riri6967/Guide-dog-rover/haptic_handle/drawings/handle_details.png

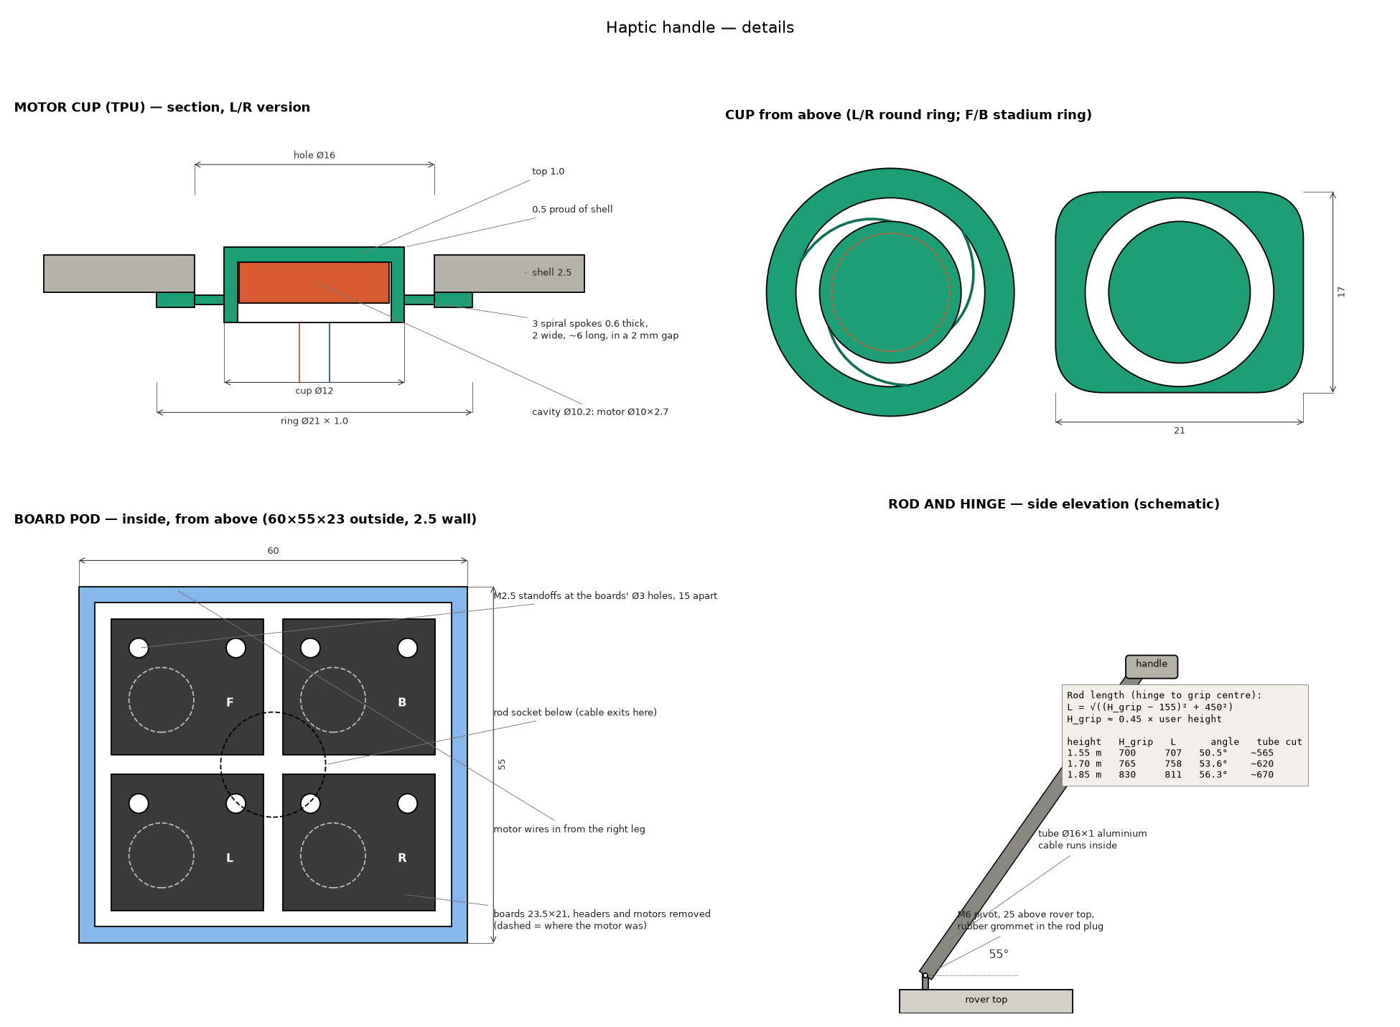
haptic_handle/drawings/handle_details.png
