riri6967/Guide-dog-rover/haptic_handle/drawings/handle_views.png

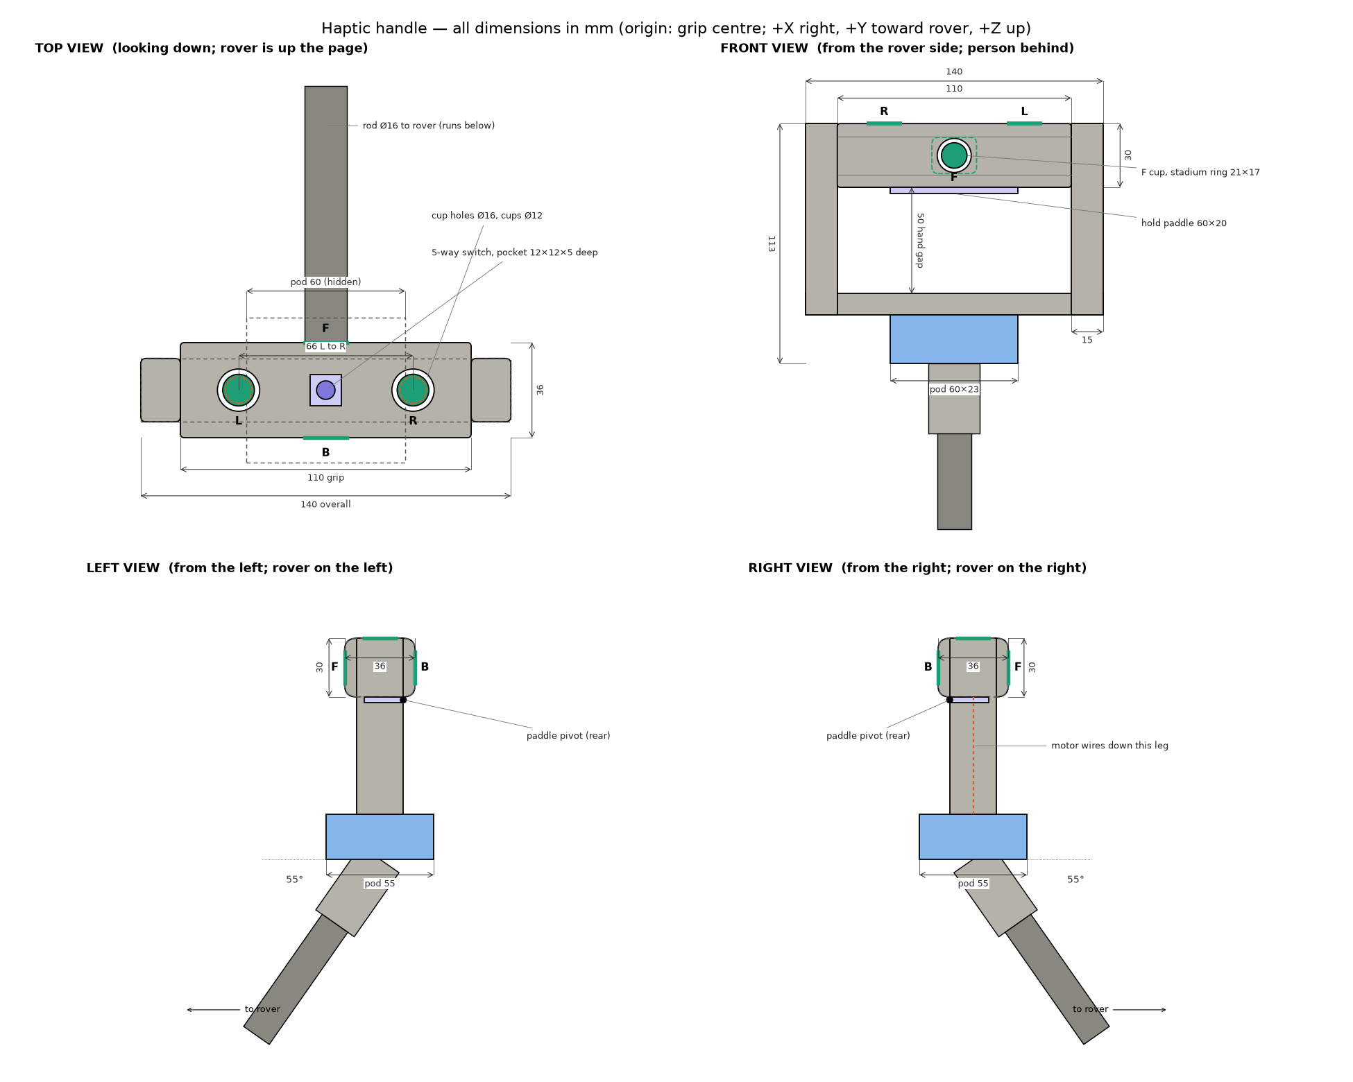
haptic_handle/drawings/handle_views.png
