riri6967/Guide-dog-rover/simulation/assistive_robot/training/worlds/gen/preview/train_samples.png

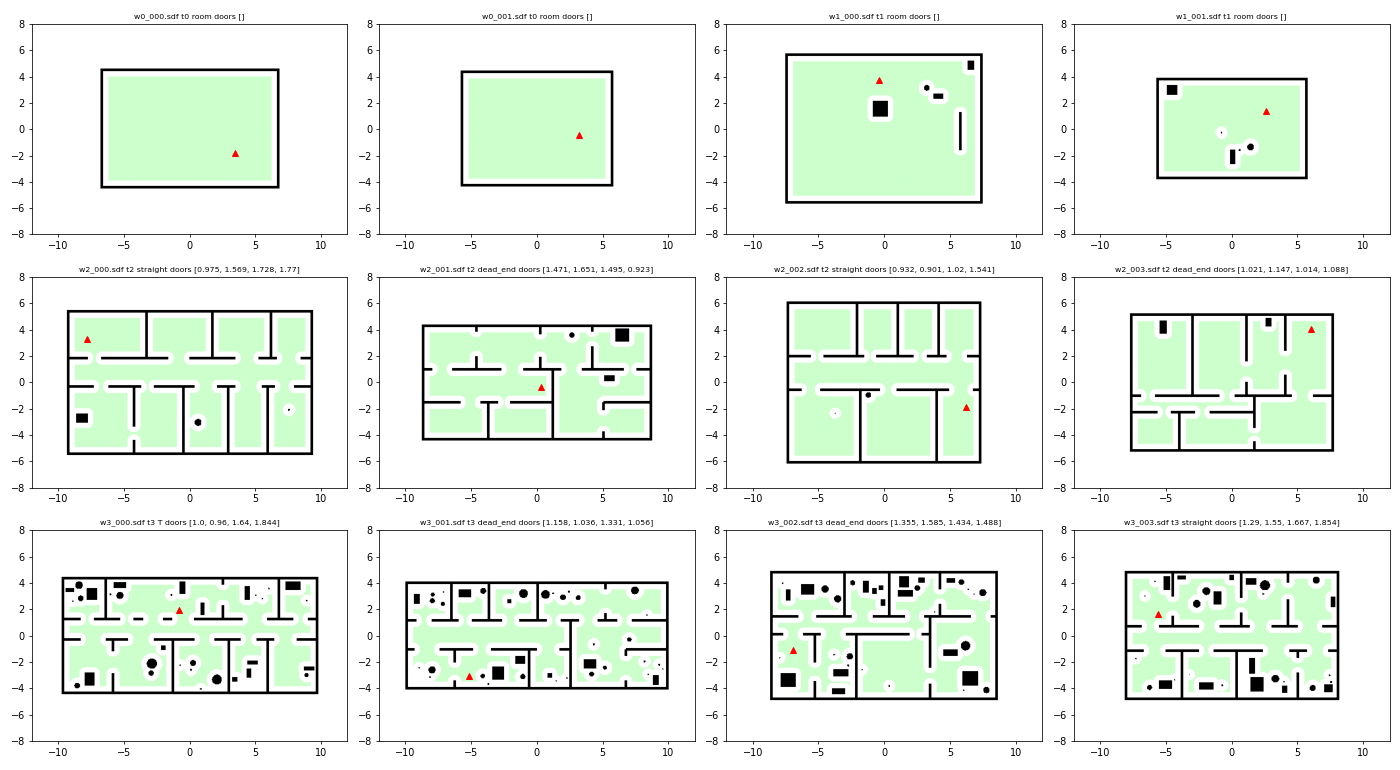
simulation/assistive_robot/training/worlds/gen/preview/train_samples.png
