riri6967/Guide-dog-rover/cad/stl/Encoder Holder Left.stl

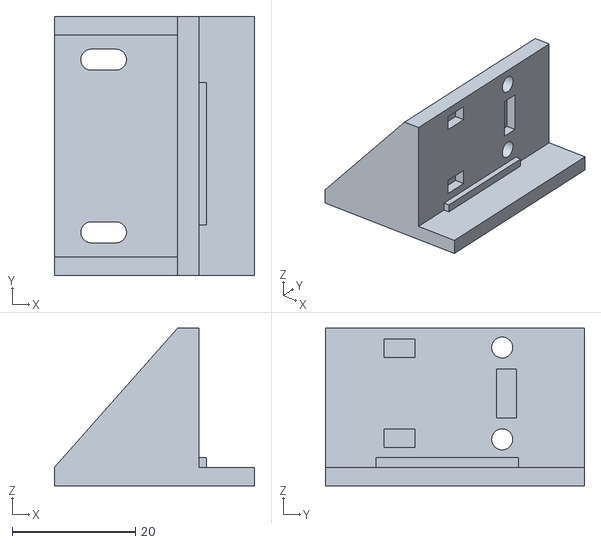
[picture p4: CAD file, 2026-11-06]
cad/stl/Encoder Holder Left.stl
32.5 x 42.0 x 25.6
