riri6967/Guide-dog-rover/raspberry_pi/ros/rover_description/meshes/shaft_extender.stl

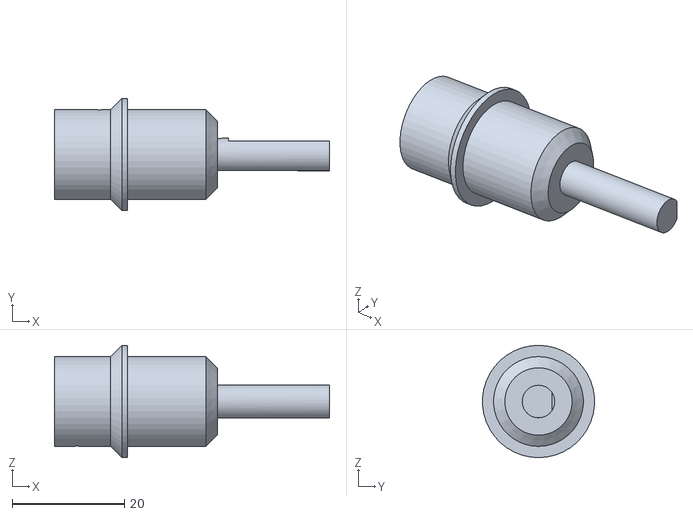
[picture p5: CAD file, 2026-11-06]
raspberry_pi/ros/rover_description/meshes/shaft_extender.stl
49.0 x 19.9 x 20.0
