riri6967/Guide-dog-rover/raspberry_pi/ros/rover_description/meshes/encoder_disc.stl

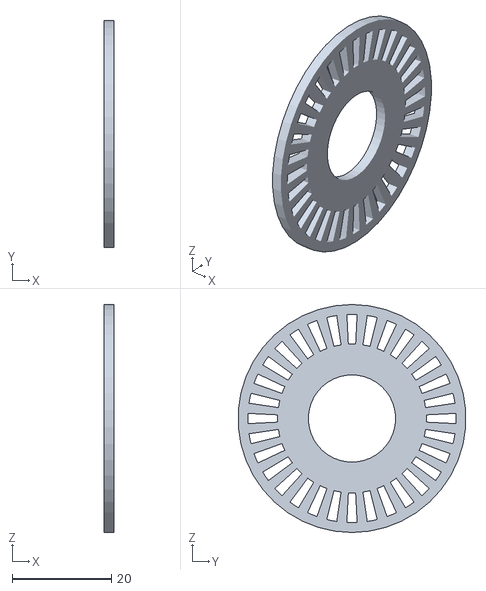
[picture p6: CAD file, 2026-11-06]
raspberry_pi/ros/rover_description/meshes/encoder_disc.stl
2.00 x 45.9 x 46.0
