riri6967/Guide-dog-rover/cad/stl/Encoder Disc B.stl

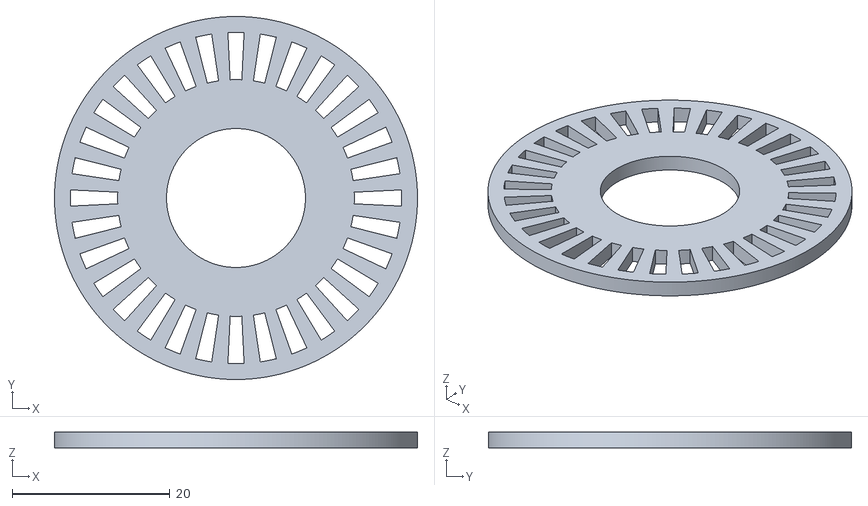
[picture p7: CAD file, 2026-11-06]
cad/stl/Encoder Disc B.stl
46.0 x 46.0 x 2.00
