riri6967/Guide-dog-rover/raspberry_pi/ros/rover_description/meshes/handle_grip.stl

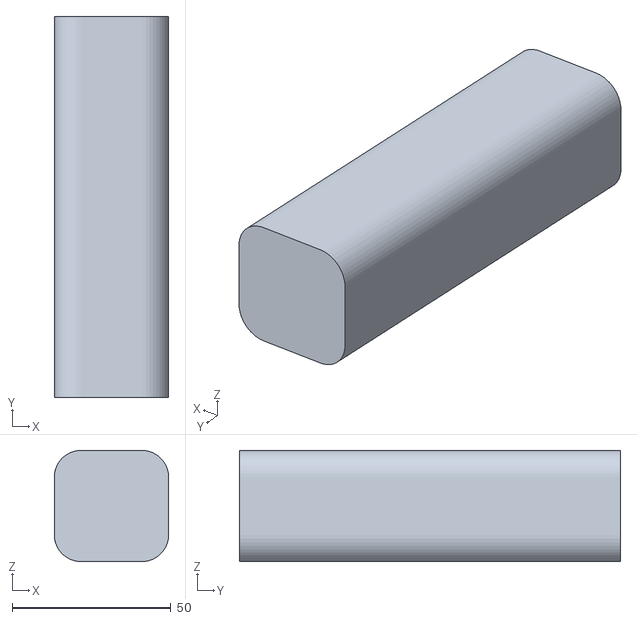
[picture p8: CAD file, 2026-11-03]
raspberry_pi/ros/rover_description/meshes/handle_grip.stl
36.0 x 120.0 x 35.0
