riri6967/Guide-dog-rover/raspberry_pi/ros/rover_description/meshes/handle_mount.stl

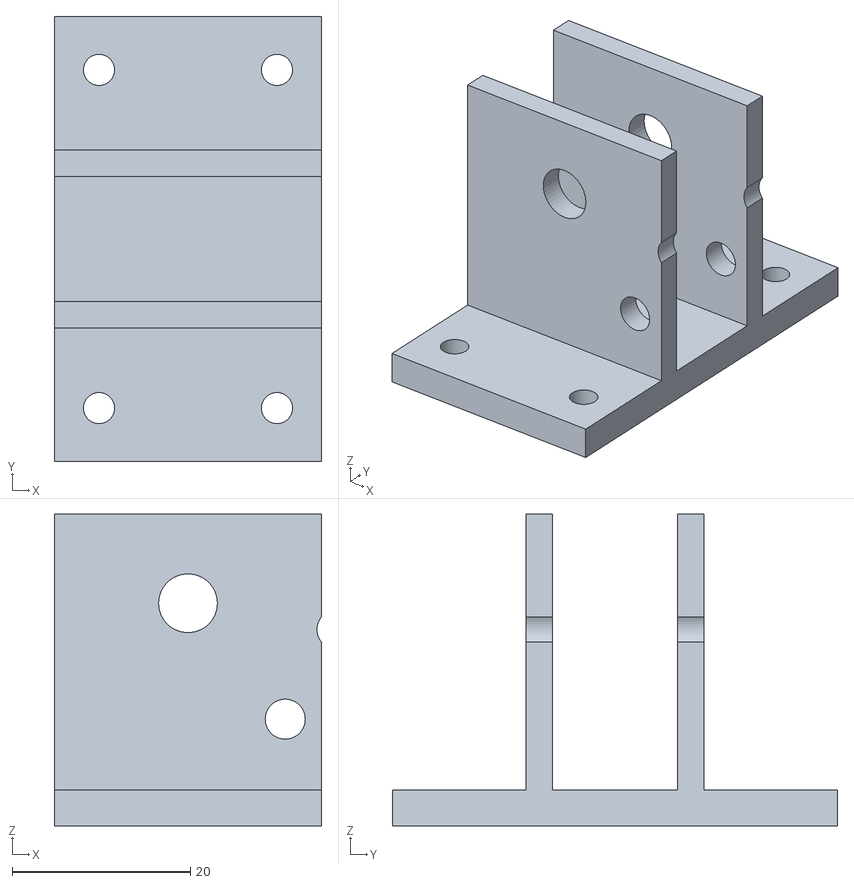
[picture p9: CAD file, 2026-11-03]
raspberry_pi/ros/rover_description/meshes/handle_mount.stl
30.0 x 50.0 x 35.0
