riri6967/Guide-dog-rover/raspberry_pi/ros/rover_description/meshes/handle_frame.stl

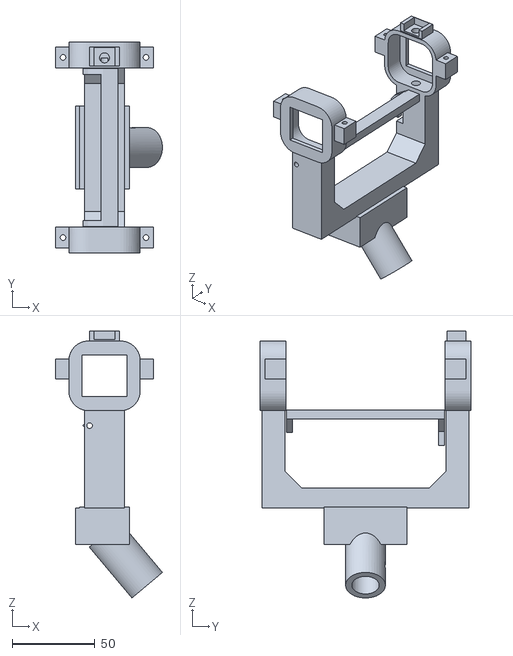
[picture p10: CAD file, 2026-11-03]
raspberry_pi/ros/rover_description/meshes/handle_frame.stl
64.4 x 127.0 x 160.9
