riri6967/Guide-dog-rover/cad/stl/Shaft Extender C.stl

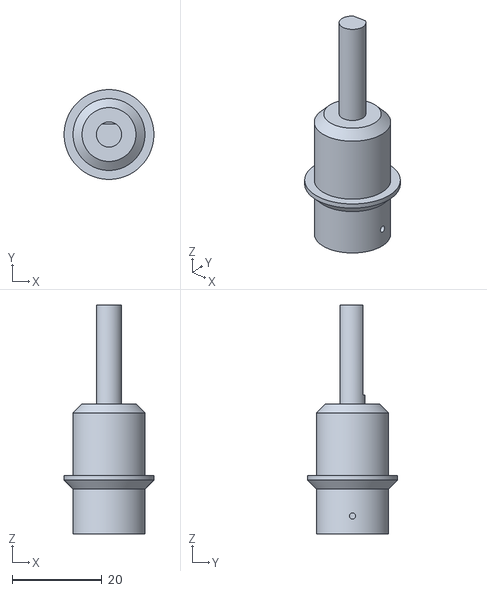
[picture p11: CAD file, 2026-11-06]
cad/stl/Shaft Extender C.stl
20.0 x 20.0 x 51.0
