riri6967/Guide-dog-rover/raspberry_pi/ros/rover_description/meshes/vibration_module.stl

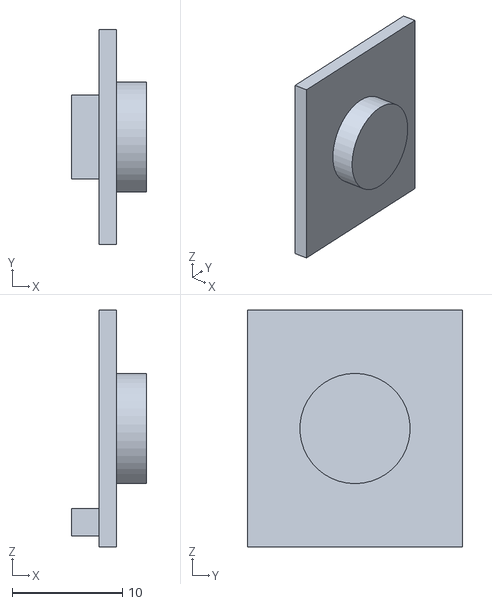
[picture p12: CAD file, 2026-11-03]
raspberry_pi/ros/rover_description/meshes/vibration_module.stl
6.80 x 19.5 x 21.5
