riri6967/Guide-dog-rover/cad/stl/Shaft Extender A.stl

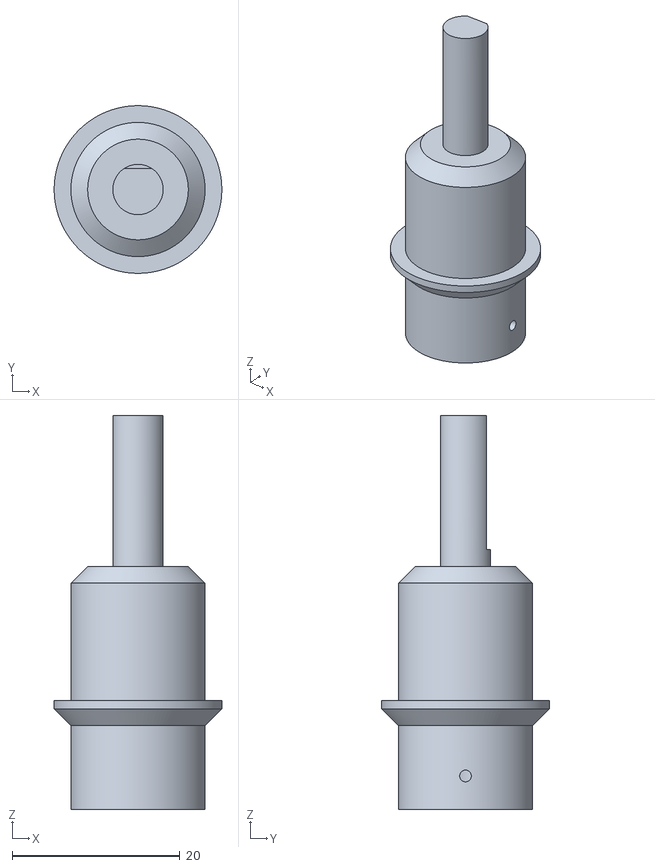
[picture p13: CAD file, 2026-11-06]
cad/stl/Shaft Extender A.stl
20.0 x 20.0 x 47.0
