riri6967/Guide-dog-rover/raspberry_pi/ros/rover_description/meshes/encoder_sensor_right.stl

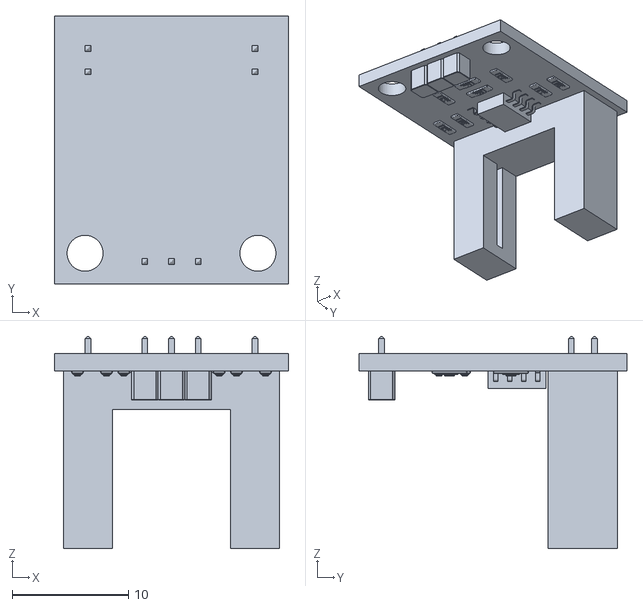
[picture p14: CAD file, 2026-11-03]
raspberry_pi/ros/rover_description/meshes/encoder_sensor_right.stl
20.2 x 23.1 x 18.3
