riri6967/Guide-dog-rover/raspberry_pi/ros/rover_description/meshes/handle_rod.stl

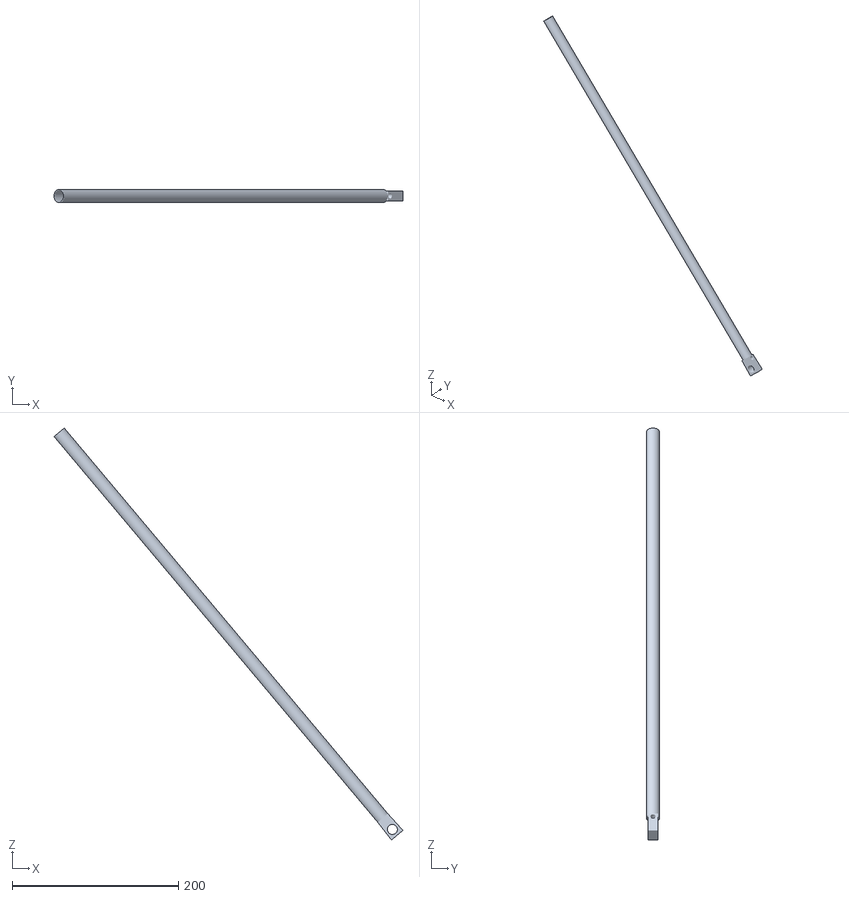
[picture p15: CAD file, 2026-11-03]
raspberry_pi/ros/rover_description/meshes/handle_rod.stl
419.3 x 16.0 x 495.1
