riri6967/Guide-dog-rover/raspberry_pi/ros/rover_description/meshes/imu.stl

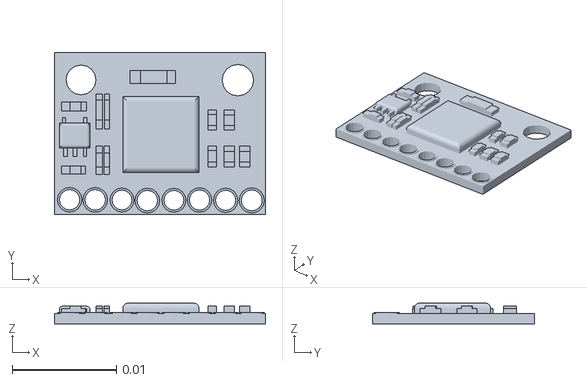
[picture p16: CAD file, 2026-10-14]
raspberry_pi/ros/rover_description/meshes/imu.stl
0.0203 x 0.0156 x 0.002
