riri6967/Guide-dog-rover/raspberry_pi/ros/rover_description/meshes/front_left_wheel.stl

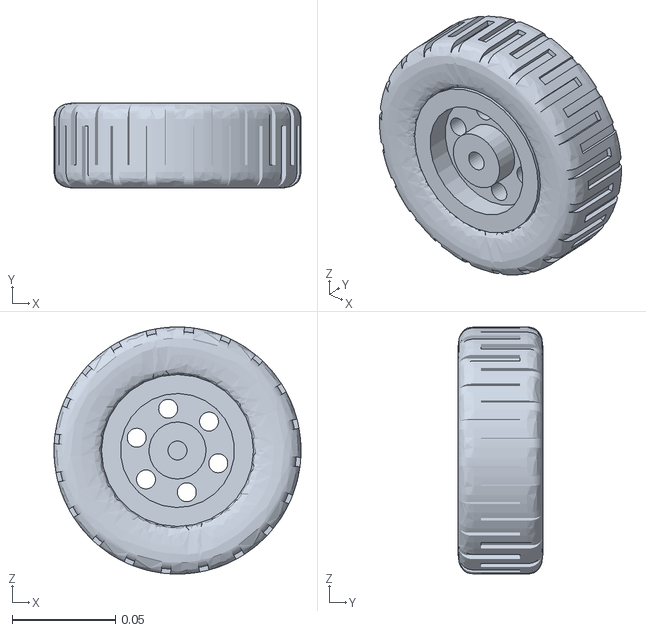
[picture p17: CAD file, 2026-10-14]
raspberry_pi/ros/rover_description/meshes/front_left_wheel.stl
0.12 x 0.0411 x 0.12
