riri6967/Guide-dog-rover/raspberry_pi/ros/rover_description/meshes/camera.stl

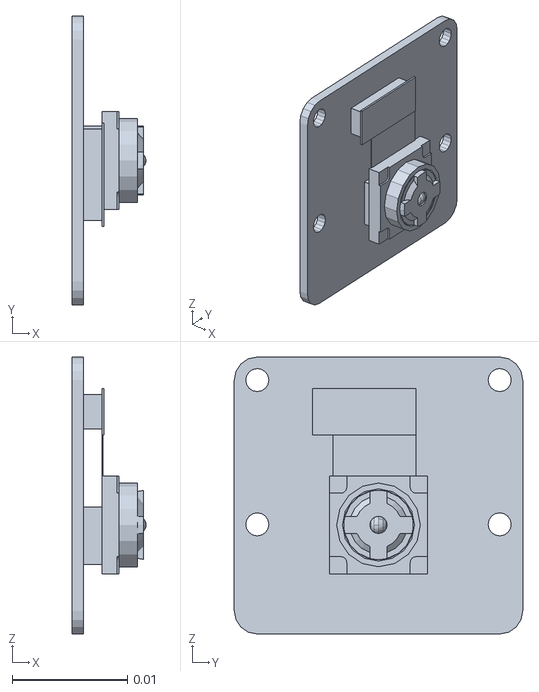
[picture p18: CAD file, 2026-10-14]
raspberry_pi/ros/rover_description/meshes/camera.stl
0.00645 x 0.025 x 0.024
