riri6967/Guide-dog-rover/raspberry_pi/ros/rover_description/meshes/lidar.stl

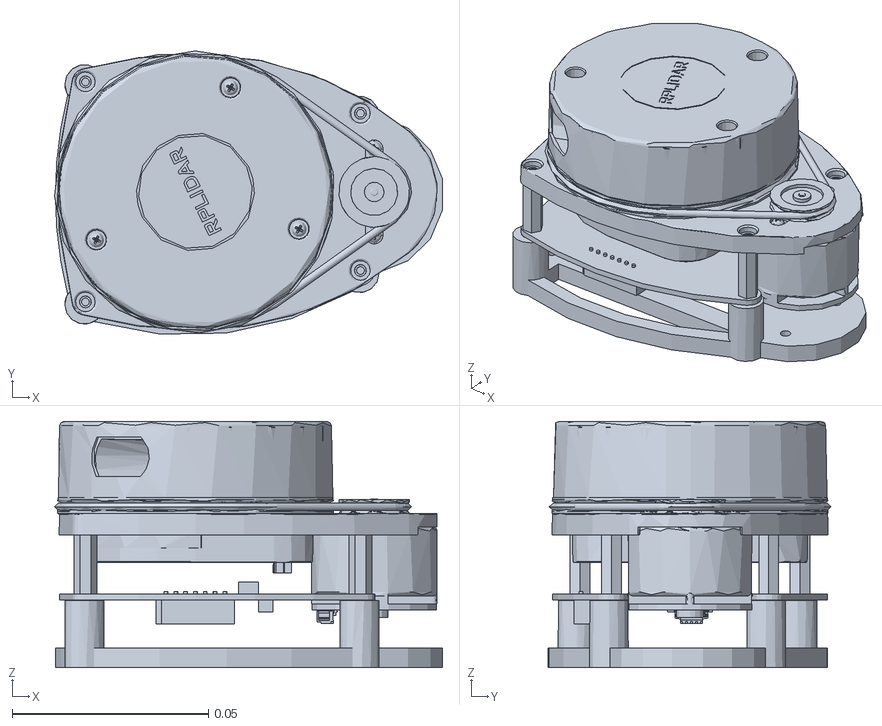
[picture p19: CAD file, 2026-10-14]
raspberry_pi/ros/rover_description/meshes/lidar.stl
0.0988 x 0.0721 x 0.0626
