riri6967/Guide-dog-rover/raspberry_pi/ros/rover_description/meshes/chassis.stl

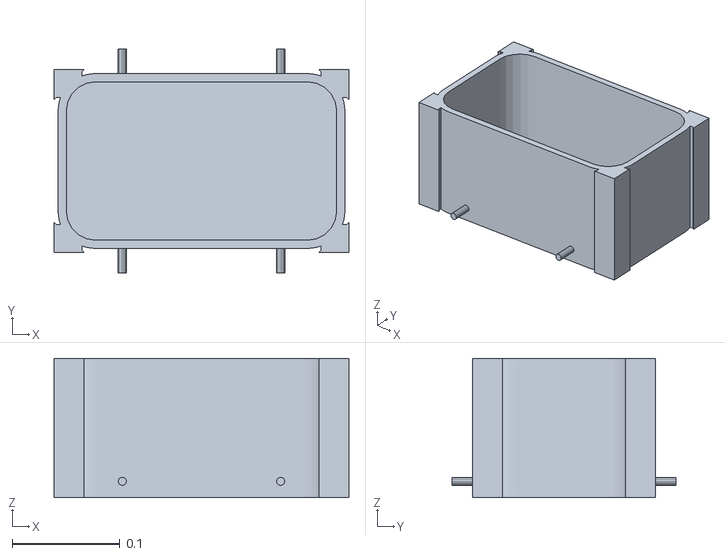
[picture p20: CAD file, 2026-10-14]
raspberry_pi/ros/rover_description/meshes/chassis.stl
0.274 x 0.208 x 0.13
