riri6967/Guide-dog-rover/(list of files, cad)

Other CAD files:
cad/stl/Encoder Holder Right.stl
cad/stl/Encoder Disc C.stl
cad/stl/Encoder Disc A.stl
cad/stl/Shaft Extender B.stl
raspberry_pi/ros/rover_description/meshes/encoder_sensor_left.stl
raspberry_pi/ros/rover_description/meshes/encoder_holder_right.stl
raspberry_pi/ros/rover_description/meshes/encoder_holder_left.stl
raspberry_pi/ros/rover_description/meshes/rear_left_wheel.stl
raspberry_pi/ros/rover_description/meshes/rear_right_wheel.stl
raspberry_pi/ros/rover_description/meshes/front_right_wheel.stl
