riri6967/Guide-dog-rover/simulation/guide_dog_simulator.html

# Guide Dog Rover Simulator

Your rover leading a blind person through the Gazebo test house. The person holds the rigid handle; the four motors in the grip tell them where they are about to be steered.

sim time 0:00 · 2× real speed

Run 6-goal tour Back to start

Click map to

Set goal Drop box Add walker

Hold (stop) Cut handle link

Speed

1× 2× 4× 8×

Pause Reset

Navigating Starting the tour

Click to send the rover somewhere · arrow keys or WASD to drive it yourself

LiDAR beams Costmap Planned path Follow rover Hear the grip (headphones)

Rover 0.90 × 0.76 m Person on the handle Planned path Too close for the rover / seen by LiDAR Furniture

## Handle grip · what the person feels

Silence

Carry on straight.

- SilenceGo forward, all clear
- Left / rightSteady buzz on that side, stronger = sharper turn
- Front pulsingObstacle ahead, faster as it gets closer
- All four pulsingStop walking
- Back steadyStep back
- Two soft pulsesArrived
- Three short pulsesLink lost, the handle has gone blind

## On the ROS graph

/cmd_vel linear.x

0.00 m/s

/cmd_vel angular.z

0.00 rad/s

/scan nearest

–

clear space ahead

–

/ticks_left

0

/ticks_right

0

pose x, y, yaw

0.00, 0.00, 0°

distance to goal

–

## Event log

## Tour results · the 6 goals from nav2/goals.csv

Goal | Where | This run | Time | Driven | Closest | Gazebo Nav2 baseline

Goals run back-to-back, each starting where the last one ended, like auto_nav2_eval_v2.py. A goal counts as reached within 0.25 m; it times out after 150 s of sim time. The last column is the frozen Gazebo baseline (3 passes each). In the full Gazebo comparison Nav2 reached 26/36 goals (72%) and the DRL + MPPI hybrid 25/36 (69%).

## Built from your project

- House layout, walls, door posts and furniture from simulation/assistive_robot/baseline_20261010/world/assistive_world.sdf, to scale.
- Rover footprint 0.90 × 0.76 m, speed up to 0.3 m/s, turn up to 1.0 rad/s, goal tolerance 0.15 m, from nav2_params.yaml.
- LiDAR: 360 beams, 0.12 to 15 m; new obstacles are marked within 3.5 m, as in the tuned costmap.
- Grip feedback ported line for line from haptic_handle/haptics.cpp: duty levels 70 / 150 / 255, deadbands 0.03 m/s and 0.10 rad/s, stop at 5 Hz, link-lost triple pulse every 1.6 s.
- Encoder ticks: 32 per wheel turn, the slotted disc in rover_microros.ino.

Simplified here: the planner is A* on a 10 cm grid with a pure-pursuit follower instead of SmacPlanner2D + MPPI, the rover knows its true position (no AMCL drift), and the DRL policy is not included. Treat the times as illustrative, not as new measurements.
