riri6967/Guide-dog-rover/simulation/assistive_robot/training/runs/sac_gen_20261010_113224/eval_test/world_log.csv

time | event | worker | world
1791621427.6 | launch | 0 | w0_000
1791621427.6 | launch | 1 | w0_001
1791621427.6 | launch | 2 | w0_002
1791621427.6 | launch | 3 | w0_003
1791621427.6 | launch | 4 | w0_004
1791621427.6 | launch | 5 | w0_005
1791621427.6 | launch | 6 | w1_000
1791621427.6 | launch | 7 | w1_001
1791621427.6 | launch | 8 | w1_002
1791621430.7 | active | 7 | w1_001
1791621430.7 | active | 4 | w0_004
1791621430.7 | active | 5 | w0_005
1791621433.5 | active | 6 | w1_000
1791621433.6 | active | 1 | w0_001
1791621433.6 | active | 0 | w0_000
1791621466.5 | active | 2 | w0_002
1791621466.5 | retire | 1 | w0_001
1791621466.5 | launch | 9 | w1_003
1791621469.6 | active | 3 | w0_003
1791621469.6 | retire | 5 | w0_005
1791621469.6 | launch | 10 | w1_004
1791621473.7 | active | 8 | w1_002
1791621473.7 | retire | 4 | w0_004
1791621473.7 | launch | 11 | w1_005
1791621480.0 | active | 9 | w1_003
1791621480.0 | retire | 0 | w0_000
1791621480.0 | launch | 12 | w1_006
1791621480.6 | active | 10 | w1_004
1791621480.6 | retire | 7 | w1_001
1791621480.6 | launch | 13 | w1_007
1791621485.1 | active | 11 | w1_005
1791621485.1 | retire | 6 | w1_000
1791621485.1 | launch | 14 | w2_000
1791621507.1 | active | 12 | w1_006
1791621507.1 | retire | 2 | w0_002
1791621507.1 | launch | 15 | w2_001
1791621512.7 | active | 13 | w1_007
1791621512.7 | retire | 8 | w1_002
1791621512.7 | launch | 16 | w2_002
1791621514.1 | active | 14 | w2_000
1791621514.1 | retire | 3 | w0_003
1791621514.1 | launch | 17 | w2_003
1791621527.4 | active | 15 | w2_001
1791621527.4 | retire | 9 | w1_003
1791621527.4 | launch | 18 | w2_004
1791621529.4 | active | 16 | w2_002
1791621529.4 | retire | 10 | w1_004
1791621529.4 | launch | 19 | w2_005
1791621537.3 | active | 17 | w2_003
1791621537.3 | retire | 12 | w1_006
1791621537.3 | launch | 20 | w2_006
1791621539.2 | active | 18 | w2_004
1791621539.2 | retire | 11 | w1_005
1791621539.2 | launch | 21 | w2_007
1791621561.8 | active | 19 | w2_005
1791621561.8 | retire | 13 | w1_007
1791621561.8 | launch | 22 | w3_000
1791621568.7 | active | 20 | w2_006
1791621568.7 | retire | 16 | w2_002
1791621568.7 | launch | 23 | w3_001
1791621572.0 | active | 21 | w2_007
1791621572.0 | retire | 15 | w2_001
1791621572.0 | launch | 24 | w3_002
1791621576.3 | active | 22 | w3_000
1791621576.3 | retire | 14 | w2_000
1791621576.3 | launch | 25 | w3_003
1791621579.3 | active | 23 | w3_001
1791621579.3 | retire | 18 | w2_004
1791621579.3 | launch | 26 | w3_004
1791621597.0 | active | 24 | w3_002
1791621597.0 | retire | 17 | w2_003
1791621597.0 | launch | 27 | w3_005
1791621604.5 | active | 25 | w3_003
1791621604.5 | retire | 20 | w2_006
1791621604.5 | launch | 28 | w3_006
1791621609.1 | active | 26 | w3_004
1791621609.1 | retire | 22 | w3_000
1791621609.1 | launch | 29 | w3_007
1791621612.3 | active | 27 | w3_005
1791621612.3 | retire | 21 | w2_007
1791621612.3 | launch | 30 | w0_000
1791621615.2 | active | 28 | w3_006
1791621615.2 | retire | 19 | w2_005
1791621615.2 | launch | 31 | w0_001
1791621615.3 | active | 29 | w3_007
1791621615.3 | retire | 23 | w3_001
1791621615.3 | launch | 32 | w0_002
1791621640.8 | active | 30 | w0_000
1791621640.8 | retire | 25 | w3_003
1791621640.8 | launch | 33 | w0_003
1791621642.0 | active | 31 | w0_001
1791621642.0 | retire | 24 | w3_002
1791621642.0 | launch | 34 | w0_004
1791621650.4 | active | 32 | w0_002
1791621650.4 | retire | 27 | w3_005
1791621650.4 | launch | 35 | w0_005
1791621651.9 | active | 33 | w0_003
1791621651.9 | retire | 26 | w3_004
1791621651.9 | launch | 36 | w1_000
1791621669.2 | active | 34 | w0_004
1791621669.2 | retire | 29 | w3_007
1791621669.2 | launch | 37 | w1_001
1791621672.5 | active | 35 | w0_005
1791621672.5 | retire | 28 | w3_006
1791621672.5 | launch | 38 | w1_002
