riri6967/Guide-dog-rover/simulation/assistive_robot/training/runs/sac_gen_20261010_142340/eval_test/world_log.csv

time | event | worker | world
1791631739.0 | launch | 0 | w0_000
1791631739.0 | launch | 1 | w0_001
1791631739.0 | launch | 2 | w0_002
1791631739.0 | launch | 3 | w0_003
1791631739.0 | launch | 4 | w0_004
1791631739.0 | launch | 5 | w0_005
1791631739.0 | launch | 6 | w1_000
1791631739.0 | launch | 7 | w1_001
1791631739.0 | launch | 8 | w1_002
1791631742.0 | active | 4 | w0_004
1791631742.1 | active | 3 | w0_003
1791631742.1 | active | 0 | w0_000
1791631744.9 | active | 7 | w1_001
1791631745.0 | active | 5 | w0_005
1791631745.0 | active | 2 | w0_002
1791631781.0 | active | 8 | w1_002
1791631781.0 | retire | 5 | w0_005
1791631781.0 | launch | 9 | w1_003
1791631789.1 | active | 1 | w0_001
1791631789.1 | retire | 2 | w0_002
1791631789.1 | launch | 10 | w1_004
1791631790.6 | active | 6 | w1_000
1791631790.6 | retire | 4 | w0_004
1791631790.6 | launch | 11 | w1_005
1791631791.0 | active | 9 | w1_003
1791631791.0 | retire | 3 | w0_003
1791631791.0 | launch | 12 | w1_006
1791631792.9 | active | 10 | w1_004
1791631792.9 | retire | 7 | w1_001
1791631792.9 | launch | 13 | w1_007
1791631801.1 | active | 11 | w1_005
1791631801.1 | retire | 0 | w0_000
1791631801.1 | launch | 14 | w2_000
1791631822.8 | active | 12 | w1_006
1791631822.8 | retire | 1 | w0_001
1791631822.8 | launch | 15 | w2_001
1791631825.9 | active | 13 | w1_007
1791631825.9 | retire | 8 | w1_002
1791631825.9 | launch | 16 | w2_002
1791631834.8 | active | 14 | w2_000
1791631834.8 | retire | 6 | w1_000
1791631834.8 | launch | 17 | w2_003
1791631838.0 | active | 15 | w2_001
1791631838.0 | retire | 9 | w1_003
1791631838.0 | launch | 18 | w2_004
1791631842.0 | active | 16 | w2_002
1791631842.0 | retire | 10 | w1_004
1791631842.0 | launch | 19 | w2_005
1791631850.1 | active | 17 | w2_003
1791631850.1 | retire | 11 | w1_005
1791631850.1 | launch | 20 | w2_006
1791631851.7 | active | 18 | w2_004
1791631851.7 | retire | 12 | w1_006
1791631851.7 | launch | 21 | w2_007
1791631868.2 | active | 19 | w2_005
1791631868.2 | retire | 13 | w1_007
1791631868.2 | launch | 22 | w3_000
1791631886.2 | active | 20 | w2_006
1791631886.2 | retire | 16 | w2_002
1791631886.2 | launch | 23 | w3_001
1791631887.0 | active | 21 | w2_007
1791631887.0 | retire | 15 | w2_001
1791631887.0 | launch | 24 | w3_002
1791631898.1 | active | 22 | w3_000
1791631898.1 | retire | 14 | w2_000
1791631898.1 | launch | 25 | w3_003
1791631904.1 | active | 23 | w3_001
1791631904.1 | retire | 18 | w2_004
1791631904.1 | launch | 26 | w3_004
1791631911.3 | active | 24 | w3_002
1791631911.3 | retire | 17 | w2_003
1791631911.3 | launch | 27 | w3_005
1791631921.2 | active | 25 | w3_003
1791631921.2 | retire | 20 | w2_006
1791631921.2 | launch | 28 | w3_006
1791631928.4 | active | 26 | w3_004
1791631928.4 | retire | 19 | w2_005
1791631928.4 | launch | 29 | w3_007
1791631933.9 | active | 27 | w3_005
1791631933.9 | retire | 22 | w3_000
1791631933.9 | launch | 30 | w0_000
1791631935.6 | active | 28 | w3_006
1791631935.6 | retire | 23 | w3_001
1791631935.6 | launch | 31 | w0_001
1791631936.4 | active | 29 | w3_007
1791631936.4 | retire | 21 | w2_007
1791631936.4 | launch | 32 | w0_002
1791631953.7 | active | 30 | w0_000
1791631953.7 | retire | 25 | w3_003
1791631953.7 | launch | 33 | w0_003
1791631957.8 | active | 31 | w0_001
1791631957.8 | retire | 24 | w3_002
1791631957.8 | launch | 34 | w0_004
1791631964.1 | active | 32 | w0_002
1791631964.1 | retire | 27 | w3_005
1791631964.1 | launch | 35 | w0_005
1791631976.9 | active | 33 | w0_003
1791631976.9 | retire | 26 | w3_004
1791631976.9 | launch | 36 | w1_000
1791631991.6 | active | 34 | w0_004
1791631991.6 | retire | 31 | w0_001
1791631991.6 | launch | 37 | w1_001
1791631994.5 | active | 35 | w0_005
1791631994.5 | retire | 28 | w3_006
1791631994.5 | launch | 38 | w1_002
1791631996.6 | active | 36 | w1_000
1791631996.6 | retire | 29 | w3_007
1791631996.6 | launch | 39 | w1_003
