riri6967/Guide-dog-rover/simulation/assistive_robot/training/runs/sac_gen_20261010_234158/eval_test/world_log.csv

time | event | worker | world
1791665231.0 | launch | 0 | w0_000
1791665231.0 | launch | 1 | w0_001
1791665231.0 | launch | 2 | w0_002
1791665231.0 | launch | 3 | w0_003
1791665231.0 | launch | 4 | w0_004
1791665231.0 | launch | 5 | w0_005
1791665231.0 | launch | 6 | w1_000
1791665231.0 | launch | 7 | w1_001
1791665231.0 | launch | 8 | w1_002
1791665234.1 | active | 5 | w0_005
1791665234.1 | active | 2 | w0_002
1791665234.2 | active | 6 | w1_000
1791665236.8 | active | 0 | w0_000
1791665236.8 | active | 3 | w0_003
1791665236.9 | active | 7 | w1_001
1791665273.5 | active | 1 | w0_001
1791665273.5 | retire | 5 | w0_005
1791665273.5 | launch | 9 | w1_003
1791665281.2 | active | 8 | w1_002
1791665281.2 | retire | 2 | w0_002
1791665281.2 | launch | 10 | w1_004
1791665282.9 | active | 4 | w0_004
1791665282.9 | retire | 3 | w0_003
1791665282.9 | launch | 11 | w1_005
1791665285.5 | active | 9 | w1_003
1791665285.5 | retire | 7 | w1_001
1791665285.5 | launch | 12 | w1_006
1791665285.9 | active | 10 | w1_004
1791665285.9 | retire | 0 | w0_000
1791665285.9 | launch | 13 | w1_007
1791665288.0 | active | 11 | w1_005
1791665288.0 | retire | 6 | w1_000
1791665288.0 | launch | 14 | w2_000
1791665308.0 | active | 12 | w1_006
1791665308.0 | retire | 1 | w0_001
1791665308.0 | launch | 15 | w2_001
1791665325.7 | active | 13 | w1_007
1791665325.7 | retire | 4 | w0_004
1791665325.7 | launch | 16 | w2_002
1791665327.2 | active | 14 | w2_000
1791665327.2 | retire | 8 | w1_002
1791665327.2 | launch | 17 | w2_003
1791665334.3 | active | 15 | w2_001
1791665334.3 | retire | 9 | w1_003
1791665334.3 | launch | 18 | w2_004
1791665337.9 | active | 16 | w2_002
1791665337.9 | retire | 10 | w1_004
1791665337.9 | launch | 19 | w2_005
1791665338.3 | active | 17 | w2_003
1791665338.3 | retire | 12 | w1_006
1791665338.3 | launch | 20 | w2_006
1791665343.4 | active | 18 | w2_004
1791665343.4 | retire | 11 | w1_005
1791665343.4 | launch | 21 | w2_007
1791665370.4 | active | 19 | w2_005
1791665370.4 | retire | 13 | w1_007
1791665370.4 | launch | 22 | w3_000
1791665372.7 | active | 20 | w2_006
1791665372.7 | retire | 15 | w2_001
1791665372.7 | launch | 23 | w3_001
1791665378.6 | active | 21 | w2_007
1791665378.6 | retire | 16 | w2_002
1791665378.6 | launch | 24 | w3_002
1791665391.1 | active | 22 | w3_000
1791665391.1 | retire | 14 | w2_000
1791665391.1 | launch | 25 | w3_003
1791665392.6 | active | 23 | w3_001
1791665392.6 | retire | 18 | w2_004
1791665392.6 | launch | 26 | w3_004
1791665407.2 | active | 24 | w3_002
1791665407.2 | retire | 17 | w2_003
1791665407.2 | launch | 27 | w3_005
1791665419.5 | active | 25 | w3_003
1791665419.5 | retire | 20 | w2_006
1791665419.5 | launch | 28 | w3_006
1791665420.7 | active | 26 | w3_004
1791665420.7 | retire | 21 | w2_007
1791665420.7 | launch | 29 | w3_007
1791665423.2 | active | 27 | w3_005
1791665423.2 | retire | 23 | w3_001
1791665423.2 | launch | 30 | w0_000
1791665428.4 | active | 28 | w3_006
1791665428.4 | retire | 22 | w3_000
1791665428.4 | launch | 31 | w0_001
1791665430.6 | active | 29 | w3_007
1791665430.6 | retire | 19 | w2_005
1791665430.6 | launch | 32 | w0_002
1791665454.7 | active | 30 | w0_000
1791665454.7 | retire | 24 | w3_002
1791665454.7 | launch | 33 | w0_003
1791665457.2 | active | 31 | w0_001
1791665457.2 | retire | 27 | w3_005
1791665457.2 | launch | 34 | w0_004
1791665463.4 | active | 32 | w0_002
1791665463.4 | retire | 25 | w3_003
1791665463.4 | launch | 35 | w0_005
1791665469.4 | active | 33 | w0_003
1791665469.4 | retire | 26 | w3_004
1791665469.4 | launch | 36 | w1_000
1791665489.9 | active | 34 | w0_004
1791665489.9 | retire | 28 | w3_006
1791665489.9 | launch | 37 | w1_001
1791665493.0 | active | 35 | w0_005
1791665493.0 | retire | 31 | w0_001
1791665493.0 | launch | 38 | w1_002
1791665493.7 | active | 36 | w1_000
1791665493.7 | retire | 29 | w3_007
1791665493.7 | launch | 39 | w1_003
