riri6967/Guide-dog-rover/simulation/assistive_robot/training/runs/sac_gen_20261011_055331/eval_test/world_log.csv

time | event | worker | world
1791687464.9 | launch | 0 | w0_000
1791687464.9 | launch | 1 | w0_001
1791687464.9 | launch | 2 | w0_002
1791687464.9 | launch | 3 | w0_003
1791687464.9 | launch | 4 | w0_004
1791687464.9 | launch | 5 | w0_005
1791687464.9 | launch | 6 | w1_000
1791687464.9 | launch | 7 | w1_001
1791687464.9 | launch | 8 | w1_002
1791687467.9 | active | 6 | w1_000
1791687468.0 | active | 2 | w0_002
1791687468.0 | active | 0 | w0_000
1791687470.6 | active | 8 | w1_002
1791687470.7 | active | 4 | w0_004
1791687470.7 | active | 7 | w1_001
1791687500.9 | active | 1 | w0_001
1791687500.9 | retire | 8 | w1_002
1791687500.9 | launch | 9 | w1_003
1791687505.4 | active | 5 | w0_005
1791687505.4 | retire | 4 | w0_004
1791687505.4 | launch | 10 | w1_004
1791687509.3 | active | 3 | w0_003
1791687509.3 | retire | 2 | w0_002
1791687509.3 | launch | 11 | w1_005
1791687509.5 | active | 9 | w1_003
1791687509.5 | retire | 0 | w0_000
1791687509.5 | launch | 12 | w1_006
1791687513.7 | active | 10 | w1_004
1791687513.7 | retire | 7 | w1_001
1791687513.7 | launch | 13 | w1_007
1791687514.9 | active | 11 | w1_005
1791687514.9 | retire | 6 | w1_000
1791687514.9 | launch | 14 | w2_000
1791687530.1 | active | 12 | w1_006
1791687530.1 | retire | 1 | w0_001
1791687530.1 | launch | 15 | w2_001
1791687539.5 | active | 13 | w1_007
1791687539.5 | retire | 5 | w0_005
1791687539.5 | launch | 16 | w2_002
1791687548.8 | active | 14 | w2_000
1791687548.8 | retire | 3 | w0_003
1791687548.8 | launch | 17 | w2_003
1791687550.4 | active | 15 | w2_001
1791687550.4 | retire | 9 | w1_003
1791687550.4 | launch | 18 | w2_004
1791687556.7 | active | 16 | w2_002
1791687556.7 | retire | 11 | w1_005
1791687556.7 | launch | 19 | w2_005
1791687557.0 | active | 17 | w2_003
1791687557.0 | retire | 12 | w1_006
1791687557.0 | launch | 20 | w2_006
1791687558.4 | active | 18 | w2_004
1791687558.4 | retire | 10 | w1_004
1791687558.4 | launch | 21 | w2_007
1791687576.2 | active | 19 | w2_005
1791687576.2 | retire | 15 | w2_001
1791687576.2 | launch | 22 | w3_000
1791687580.4 | active | 20 | w2_006
1791687580.4 | retire | 13 | w1_007
1791687580.4 | launch | 23 | w3_001
1791687589.2 | active | 21 | w2_007
1791687589.2 | retire | 16 | w2_002
1791687589.2 | launch | 24 | w3_002
1791687598.9 | active | 22 | w3_000
1791687598.9 | retire | 14 | w2_000
1791687598.9 | launch | 25 | w3_003
1791687604.8 | active | 23 | w3_001
1791687604.8 | retire | 18 | w2_004
1791687604.8 | launch | 26 | w3_004
1791687613.3 | active | 24 | w3_002
1791687613.3 | retire | 20 | w2_006
1791687613.3 | launch | 27 | w3_005
1791687619.0 | active | 25 | w3_003
1791687619.0 | retire | 17 | w2_003
1791687619.0 | launch | 28 | w3_006
1791687624.0 | active | 26 | w3_004
1791687624.0 | retire | 19 | w2_005
1791687624.0 | launch | 29 | w3_007
1791687629.4 | active | 27 | w3_005
1791687629.4 | retire | 21 | w2_007
1791687629.4 | launch | 30 | w0_000
1791687632.3 | active | 28 | w3_006
1791687632.3 | retire | 22 | w3_000
1791687632.3 | launch | 31 | w0_001
1791687634.8 | active | 29 | w3_007
1791687634.8 | retire | 23 | w3_001
1791687634.8 | launch | 32 | w0_002
1791687648.4 | active | 30 | w0_000
1791687648.4 | retire | 24 | w3_002
1791687648.4 | launch | 33 | w0_003
1791687653.1 | active | 31 | w0_001
1791687653.1 | retire | 25 | w3_003
1791687653.1 | launch | 34 | w0_004
1791687658.9 | active | 32 | w0_002
1791687658.9 | retire | 26 | w3_004
1791687658.9 | launch | 35 | w0_005
1791687663.2 | active | 33 | w0_003
1791687663.2 | retire | 27 | w3_005
1791687663.2 | launch | 36 | w1_000
1791687680.8 | active | 34 | w0_004
1791687680.8 | retire | 31 | w0_001
1791687680.8 | launch | 37 | w1_001
1791687681.2 | active | 35 | w0_005
1791687681.2 | retire | 29 | w3_007
1791687681.2 | launch | 38 | w1_002
1791687687.6 | active | 36 | w1_000
1791687687.6 | retire | 28 | w3_006
1791687687.6 | launch | 39 | w1_003
