riri6967/Guide-dog-rover/simulation/assistive_robot/baseline_20261010/results/nav2_eval_v2_20261010_002625.csv

repeat | goal | goal_x | goal_y | status | success_real | duration_s | recoveries | start_x | start_y | start_yaw | end_x | end_y | end_yaw | real_dist_to_goal_m | yaw_error_deg | path_len_m | straight_m | efficiency | min_lidar_m | contact_pairs
1 | candidate_1 | -5.0 | 4.0 | TIMEOUT | False | 150.0 | 8 | 0.0 | 0.0 | -0.0 | -4.95 | 3.78 | 8.0 | 0.22 | 8.0 | 9.61 | 6.4 | 0.67 | 0.71
1 | candidate_2 | 5.0 | -4.0 | SUCCEEDED | True | 119.1 | 1 | -4.95 | 3.78 | 8.0 | 5.1 | -3.93 | 4.0 | 0.13 | 4.0 | 16.69 | 12.63 | 0.76 | 0.66
1 | candidate_3 | -3.0 | 0.0 | SUCCEEDED | True | 87.1 | 0 | 5.1 | -3.93 | 4.0 | -3.01 | -0.02 | -20.0 | 0.03 | -20.0 | 11.11 | 9.01 | 0.81 | 0.65
1 | candidate_4 | 3.0 | 4.0 | SUCCEEDED | True | 59.7 | 0 | -3.01 | -0.02 | -20.0 | 2.97 | 4.02 | -3.0 | 0.03 | -3.0 | 7.8 | 7.23 | 0.93 | 0.65
1 | candidate_5 | 5.0 | 2.0 | TIMEOUT | False | 150.0 | 13 | 2.97 | 4.02 | -3.0 | 5.04 | 2.34 | -5.0 | 0.34 | -5.0 | 4.97 | 2.86 | 0.58 | 0.72
1 | candidate_6 | -5.0 | 2.5 | TIMEOUT | False | 150.0 | 8 | 5.04 | 2.34 | -5.0 | -2.62 | 0.66 | 185.0 | 3.01 | -175.0 | 9.84 | 10.04 | 1.02 | 0.63
