riri6967/Guide-dog-rover/simulation/assistive_robot/baseline_20261010/results/nav2_eval_v2_20261010_004313.csv

repeat | goal | goal_x | goal_y | status | success_real | duration_s | recoveries | start_x | start_y | start_yaw | end_x | end_y | end_yaw | real_dist_to_goal_m | yaw_error_deg | path_len_m | straight_m | efficiency | min_lidar_m | contact_pairs
1 | candidate_1 | -5.0 | 4.0 | SUCCEEDED | True | 64.2 | 0 | -0.02 | 0.09 | 1.0 | -5.17 | 3.88 | 12.0 | 0.21 | 12.0 | 8.64 | 6.33 | 0.73 | 0.69
1 | candidate_2 | 5.0 | -4.0 | SUCCEEDED | True | 116.9 | 0 | -5.17 | 3.88 | 12.0 | 5.17 | -3.93 | -7.0 | 0.19 | -7.0 | 16.36 | 12.86 | 0.79 | 0.65
1 | candidate_3 | -3.0 | 0.0 | SUCCEEDED | True | 100.2 | 1 | 5.17 | -3.93 | -7.0 | -3.21 | 0.03 | -23.0 | 0.22 | -23.0 | 10.71 | 9.07 | 0.85 | 0.68
1 | candidate_4 | 3.0 | 4.0 | SUCCEEDED | True | 62.6 | 0 | -3.21 | 0.03 | -23.0 | 2.92 | 3.94 | 9.0 | 0.1 | 9.0 | 7.88 | 7.37 | 0.94 | 0.66
1 | candidate_5 | 5.0 | 2.0 | TIMEOUT | False | 150.0 | 14 | 2.92 | 3.94 | 9.0 | 4.92 | 2.21 | 202.0 | 0.23 | -158.0 | 3.77 | 2.85 | 0.76 | 0.6
1 | candidate_6 | -5.0 | 2.5 | SUCCEEDED | True | 121.4 | 4 | 4.92 | 2.21 | 202.0 | -4.88 | 2.58 | -1.0 | 0.14 | -1.0 | 12.67 | 9.92 | 0.78 | 0.56
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
