riri6967/Guide-dog-rover/haptic_handle/grip_sim/results/crosstalk_150Hz.png

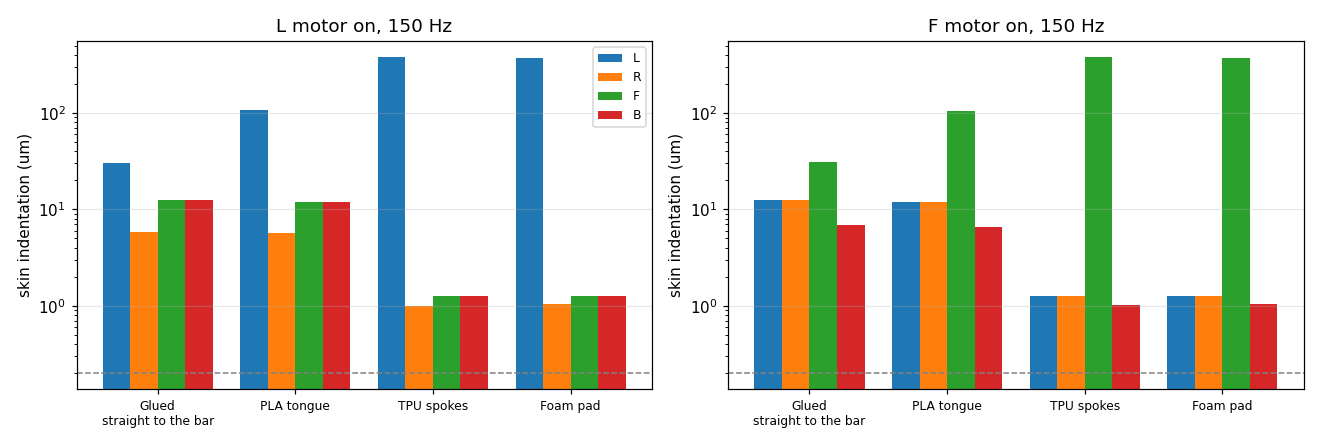
haptic_handle/grip_sim/results/crosstalk_150Hz.png
