riri6967/Guide-dog-rover/haptic_handle/grip_sim/results/rover_transmission.png

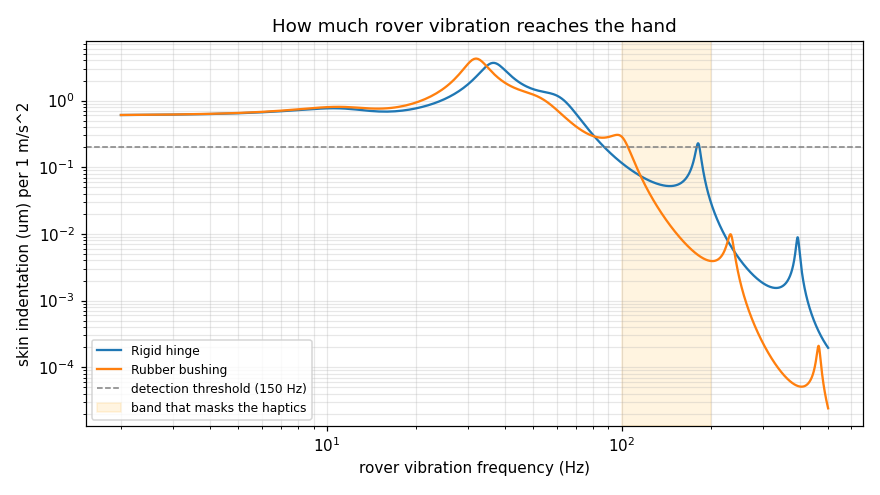
haptic_handle/grip_sim/results/rover_transmission.png
