riri6967/Guide-dog-rover/haptic_handle/grip_sim/results/sensitivity.png

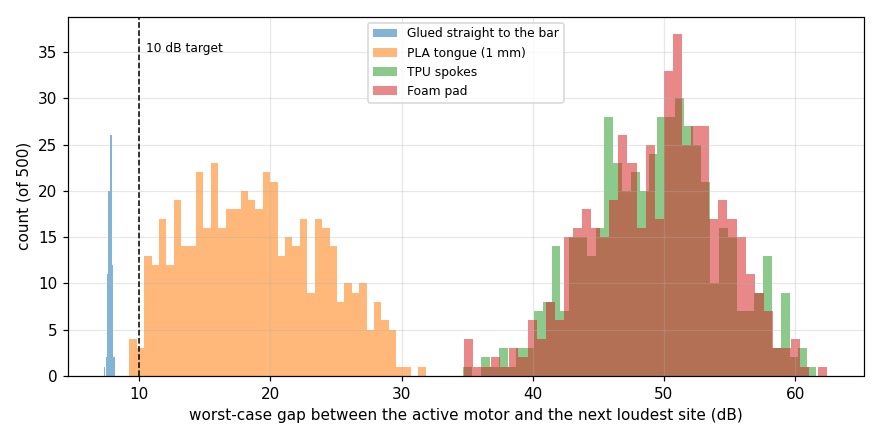
haptic_handle/grip_sim/results/sensitivity.png
