riri6967/Guide-dog-rover/haptic_handle/grip_sim/results/sweep_left_motor.png

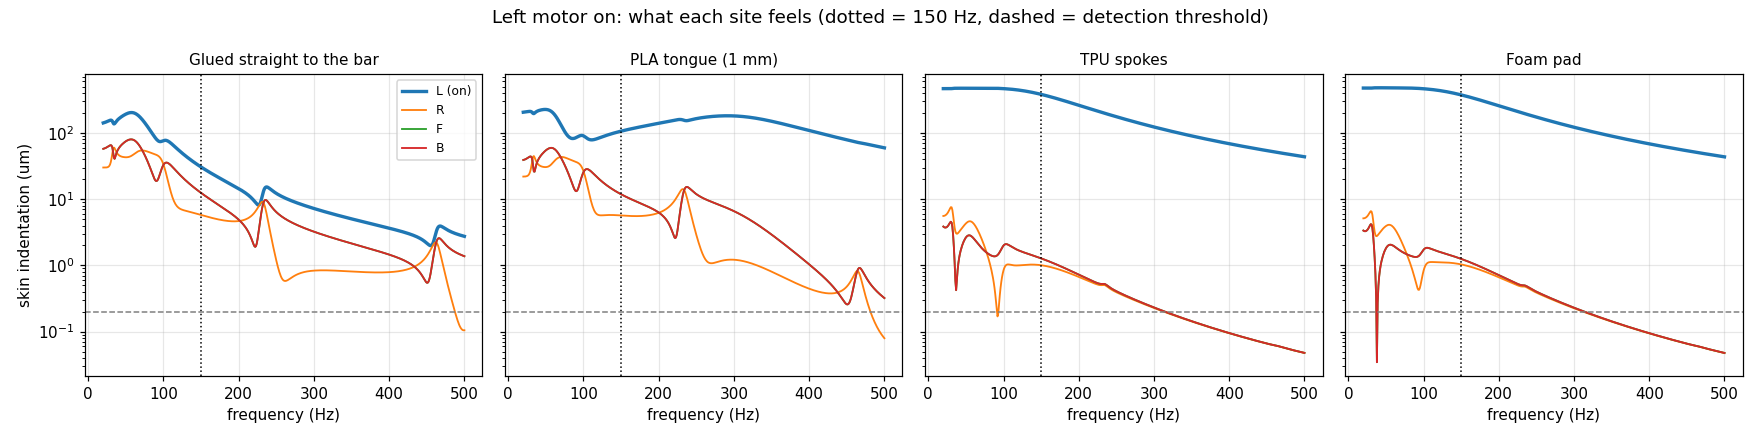
haptic_handle/grip_sim/results/sweep_left_motor.png
