riri6967/Guide-dog-rover/esp32/rover_microros/pins.h

/*
 * pins.h — single authority for every GPIO on the rover.
 *
 * Nothing else in the project should hardcode a pin number. If you move a
 * wire, you change it here and only here.
 *
 * ESP32 pin rules this layout obeys:
 *   GPIO 6-11    flash memory. Using them bricks the boot. Not broken out on
 *                most DevKits anyway.
 *   GPIO 34-39   input ONLY. No output, no internal pullup. Good for sensor
 *                inputs and ADC, useless for driving anything.
 *   GPIO 0,2,5,12,15   strapping pins, sampled at boot. 12 is the dangerous
 *                one: held HIGH at reset it sets flash to 1.8V and the board
 *                stops booting. All four are avoided here.
 *   GPIO 1,3     USB serial (TX0/RX0). Leave alone or you lose the monitor.
 *   ADC2 (0,2,4,12-15,25-27) cannot do analogRead() while WiFi is running.
 *                Every analog input below is therefore on ADC1 (32-39).
 */
#pragma once

// ---------------------------------------------------------------- L298N
// All four IN pins are plain GPIOs that sit LOW through boot, so the motors
// cannot twitch while the chip starts.
#define PIN_ENA   13    // left  pair PWM      -> ENA  (jumper removed)
#define PIN_IN1   26    // left  direction A   -> IN1
#define PIN_IN2   27    // left  direction B   -> IN2
#define PIN_ENB   14    // right pair PWM      -> ENB  (jumper removed)
#define PIN_IN3   25    // right direction A   -> IN3
#define PIN_IN4   33    // right direction B   -> IN4

// ------------------------------------------------------- battery monitor
// ADC1, so it keeps working with WiFi up. Input-only pin, which is correct
// for an ADC input. Needs the divider described in docs/WIRING.md.
#define PIN_VBAT  34

// ------------------------------------------------------------ encoders
// LM393 slot sensors, one per side, reading a slotted disc on each axle.
// Printed as D18/D19 on the 38-pin DevKit and G18/G19 on the 30-pin.
// Power the sensor modules from 3V3 so OUT never exceeds 3.3V.
#define PIN_ENC_L   18
#define PIN_ENC_R   19

// ------------------------------------------------------------ IMU (I2C)
// Not used on this board: the MPU6050 is wired to the Raspberry Pi, so 21 and
// 22 carry two of the haptic motors below. Kept for reference only.
#define PIN_SDA     21
#define PIN_SCL     22

// ------------------------------------------- haptic handle (guide grip)
// Four "DC vibration motor" modules (each a MOSFET switch + coin motor),
// one per direction; see docs/CANE.md. The pin goes to the module's IN; VCC is a
// separate 5V supply, never the ESP32's 3V3. All four are PWM-capable, so
// intensity is controllable.
#define PIN_HAP_FRONT  23
#define PIN_HAP_BACK   32
#define PIN_HAP_LEFT   21
#define PIN_HAP_RIGHT  22

// Handle controls, both on input-only pins (no internal pull-ups there).
// 5-way thumb switch on a resistor ladder: one ADC1 pin reads all five.
#define PIN_HAP_SWITCH 36   // VP; ladder between 3V3 and GND
// Hold lever: closed while the grip is held. Needs an external 10k pull-up
// to 3V3; reads LOW when held. Released = stop the rover.
#define PIN_HAP_HOLD   39   // VN

// ------------------------------------------------------------- indicators
#define PIN_LED      2    // onboard LED on most DevKits. Output-only use of a
                          // strapping pin after boot is fine.

// Still free: 0 (BOOT button), 4, 5, 12, 15, 35 (input only). 16/17 are not
// broken out on this DevKit.
