riri6967/Guide-dog-rover/(commit log)

2026-10-05 Initial commit: ESP32 rover firmware and Pi-side tooling
    ESP32 (micro-ROS node `rover_base`):
    - rover_microros: /cmd_vel subscriber, /odom + raw encoder tick publishers,
    900ms command-timeout failsafe, automatic agent reconnection
    - motors: two-L298N skid steer with ramping, deadband and per-side trim
    - encoders: interrupt-driven pulse counting on two LM393 slot sensors
    Standalone sketches for bringing hardware up without ROS in the way:
    - rover_control: WiFi AP, phone web UI, mode machine
    - rover_base: serial keyboard control
    - motor_smoketest: raw digitalWrite diagnostic
    - encoder_test: ticks-per-revolution calibration
    Pi-side:
    - start_agent.sh: works around two traps — the serial po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
    [encoder_bracket.scad, encoder_disc.scad]
2026-10-05 Add BUILD.md: full project handbook
    Consolidates what exists into one reference: architecture, what has been
    verified on hardware versus what is only written, the hardware and pin map,
    toolchain setup for both the Arduino and Pi sides, step-by-step running
    instructions, the ROS interface, and the troubleshooting that took the longest
    to work out.
    The troubleshooting section is the part worth keeping — the DTR/RTS reset trap,
    serial re-enumeration after motor EMI, and the stale ros2 daemon are all
    undocumented upstream and each one looks like a different failure than it is.
2026-10-12 Add drive_and_measure; record measured TICKS_PER_REV and the EMI finding
    drive_and_measure drives the motors and reports encoder RPM in one sketch,
    over USB with no ROS in the way. It is where the calibration constants come
    from: 'c' counts raw pulses for a hand-turned ten revolutions, 'm' sweeps the
    duty and reports the speed at each level.
    TICKS_PER_REV is now measured at 140 — 1392 and 1402 pulses over ten wheel
    turns, agreeing within 0.7%. Set in both drive_and_measure and rover_microros.
    That figure is trustworthy because it was taken by hand with the motors off.
    Counts taken while driving are not. They imply wheel speeds in the thousands
    of RPM, which means motor EMI is false-trigg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
    [drive_and_measure.ino, rover_microros.ino]
2026-10-12 Add web_teleop: drive the rover from a phone with ROS in the loop
    Serves a touch control page from the Pi and publishes /cmd_vel from it, so a
    demo shows the whole architecture rather than just the drivetrain: phone to Pi
    web page to /cmd_vel to micro-ROS to ESP32 to motors, with ticks and odometry
    returning on the same page.
    Two independent failsafes. The browser repeats while a key is held and this
    node zeroes after 500ms of silence; the ESP32 stops on its own after 900ms.
    Neither depends on the other, which is the point — every way of losing control
    looks identical from the rover's side.
    rover_control remains the fallback for a demo with nothing to go wrong: the
    ESP32 is its own acces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
    [rover.urdf.xacro]
2026-10-14 URDF: measure from CAD, add meshes
    Rebuild rover_description from the SolidWorks assembly (Assem1.STEP)
    instead of estimates. Wheel size, track, wheelbase, body extents and
    the LiDAR/camera/IMU poses all come from the CAD; each link gets an
    STL visual mesh exported in its own frame.
    - tools/step_to_meshes.py regenerates the meshes from the STEP file
    - LiDAR yaw = pi (A1 driver 0 deg faces the motor tail, which is at the
    rear) and IMU yaw = -pi/2 (GY-521 pin row faces the rear); both still
    need confirming on hardware
    - Un-ignore the URDF meshes (*.stl was ignored for OpenSCAD exports)
    and mark STL as binary
    [camera.stl, chassis.stl, front_left_wheel.stl, front_right_wheel.stl, imu.stl, lidar.stl, rear_left_wheel.stl, rear_right_wheel.stl]
2026-10-14 Add simulation work: Nav2 baseline and DRL local navigation
    Import pushkar's assistive_robot handoff (2026-10-12) under sim/: a ROS 2
    Jazzy + Gazebo package comparing Nav2, a SAC local controller and hybrids,
    judged against Gazebo ground truth. House result: Nav2 26/36 (72%),
    hybrid 25/36 (69%), DRL alone 4/18 (22%).
    The simulated rover is 0.90 x 0.76 m with its LiDAR at 0.96 m; the real
    one is 0.27 x 0.26 m with its LiDAR at 0.23 m. sim/README.md records
    this, so the policies and Nav2 tuning are not used on the robot as-is.
    Cleaned on import: file backups, empty worker logs and the models of runs
    other than the best one (run 3) are left out. .gitignore lets that one
    model.zip through.
    Co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
    [assistive_home.sdf, assistive_world.sdf, drl_eval_20261010_214608_INVALID_bt_server_timeout.csv, drl_eval_run2_20261010_214914_passA_trapped_at_doorpost.csv, drl_run2_nopillar_A_20261010_223736_INVALID_controller_crashed.csv, drl_run2_nopillar_A_20261010_224422.csv, drl_run2_nopillar_B_20261010_224126_INVALID_controller_crashed.csv, drl_run2_nopillar_B_20261010_225340.csv]
2026-10-14 URDF: use the 65 mm wheels actually fitted
    The CAD has 119.6 mm tyres; the robot runs 65 mm wheels, matching
    WHEEL_DIAMETER_M in the firmware. wheel_radius 0.0598 -> 0.0325. The CAD
    wheel mesh is scaled radially to match, keeping its tread width.
    Sensor poses are unchanged (the axles are fixed to the body), so the
    whole robot sits 27 mm lower: LiDAR 0.21 m above the floor, 17 mm under
    the body. sim/README.md updated to match.
    Track width is still unresolved: firmware 0.200 m vs CAD 0.2146 m.
    [rover.urdf.xacro]
2026-10-14 Pi bringup, Pi-side odometry, speed PID, 4S battery docs
    ros/rover_bringup (new): one launch file starts the micro-ROS agent, the
    URDF, wheel odometry, the MPU6050, a robot_localization EKF, the RPLIDAR
    A1M8 and the Pi Camera v3, each with the frame name the URDF expects.
    - wheel_odometry: /ticks_left + /ticks_right -> /wheel/odom and the four
    wheel joints. Re-syncs after a gap in ticks (ESP32 reboot). Has an
    effective_track_width parameter for skid-steer turning.
    - mpu6050_imu: I2C -> /imu/data_raw in imu_link, gyro bias at start-up.
    - ekf.yaml: fuses wheel vx/vy and gyro yaw rate.
    - udev rules for /dev/esp32 and /dev/rplidar; start_agent.sh prefers
    /dev/esp32 and never opens the LiDA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
    [mpu6050_imu.py, rover_microros.ino]
2026-10-14 Use measured wheels (110 mm) and track (240 mm) everywhere
    The robot's wheels are 110 mm and its track 240 mm, measured. Set in all
    three places that hold the geometry: the firmware (WHEEL_DIAMETER_M,
    TRACK_WIDTH_M), wheel_odometry's defaults, and the URDF (wheel_radius
    0.055, track_width 0.240; the CAD wheel mesh is scaled radially to match).
    Sensor poses are unchanged. LiDAR now 0.23 m above the floor.
    Supersedes the urdf-65mm-wheels branch. Firmware compiles (395 KB).
    [rover.urdf.xacro]
2026-10-15 Haptic handle: rigid one-hand grip design and vibration simulation
    CANE.md rewritten around the wired, one-hand handle (replacing the
    wireless ESP32-C3 cane): 110 mm grip, 34 x 28 mm oval, motors at L/R
    (66 mm apart, on top) and F/B (front and back faces), each in a soft TPU
    cup (or foam) so it does not shake the whole bar. Vibration language,
    5-way thumb switch, hold lever (released = stop), parts list for the
    DC vibration motor modules, wiring, build order.
    _cane_later/grip_sim/grip_vibration_sim.py: frequency-domain model of
    rod, grip, motor mounts, hand and skin, plus rover vibration up the rod.
    At 150 Hz the gap between the active motor and the next strongest site
    is 7.8 dB glued, 19 d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
    [pins.h]
2026-10-15 Haptic handle: U-frame, dimensioned drawings, cup sized for flat faces
    Modelling the full handle showed three problems: the rod cannot attach
    at the front of the bar where the F motor sits, a cup ring cannot seat on
    the tight curve of an oval's front and back, and the 18 mm hole is too big
    for a 30 mm-tall face. So:
    - U-frame like a guide-dog harness handle: legs at each end, a
    cross-member with a 50 mm hand gap, the board pod under it, and the rod
    socket at 55 degrees on the pod.
    - Grip is a 36 x 30 rounded rectangle (R6) with flats for the cups.
    - Cups: 16 mm hole, 12 mm cup, spiral spokes in a 2 mm gap, round ring for
    L/R and a 21 x 17 stadium ring for F/B. Boards live in the pod; o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
    [handle_drawings.py]
2026-10-17 Haptic handle: CadQuery model built around the user's grip
    build_handle.py imports Grip Top Part A/B (the user's SolidWorks grip,
    120 x 35 x 36 mm, board pockets on both end caps, front and back) and
    builds the rest in the grip's own coordinates so origins coincide in
    SolidWorks: frame (end cradles, legs, cross-piece 50 mm below the bar,
    junction pod, rod socket at 50 deg, internal wire channel), two caps
    (right one carries the 5-way switch), a squeeze bail on M3 pivots with a
    microswitch pocket in the right leg, pod lid, rod plug and rover hinge
    bracket. Exports one STEP per part plus an assembly STEP.
    Interference check: no overlaps between any parts.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
2026-10-17 Handle CAD: microswitch pocket sized for a subminiature lever switch
2026-10-17 Handle CAD: print clearances, gussets, plug holes, print prep
    - Clearances for FDM: grip in cradles 0.5/side, rod bore 16.5, plug in
    tube 0.2/side, M3 clearance 3.4, bracket gap 14 for the 12 mm tongue,
    bail arms 1 mm off the legs, switch and microswitch pockets +0.3/side.
    Heat-set insert holes stay at the maker's sizes.
    - 10 mm gussets where the legs meet the cross-piece.
    - Rod plug: cable path out of the plug and an M3 cross-bolt hole.
    - print_prep.py: re-checks interference, picks each part's best way up
    by support area and exports print-ready STLs.
2026-10-17 Handle CAD: print guide, grip STLs, weight estimate
    print_prep.py now also exports the user's grip (Part A with the 6 mm
    wire hole under the right cradle, Part B laid flat), picks each part's
    way up, and writes PRINT_GUIDE.md: PETG for everything, gyroid infill
    15-40 %, 2-4 walls by load, supports and brim per part, estimated
    weights (~158 g total vs ~211 g solid) and the full hardware list.
2026-10-17 Shaft extender with built-in encoder disc, sensor holder, 290 mm track
    encoder_extender.py (CadQuery) builds:
    - Shaft extender: slides over the motor's 6 mm round shaft (bore 6.3,
    two M1.7 set screws), carries a 32-slot encoder disc 5 mm off the
    motor face, and gives the wheel a new 6 mm shaft (15 mm, with a flat
    for its set screw) 25 mm further out. Prints standing on the disc,
    no supports.
    - Encoder holder: clamps round the gearbox (37 mm default, measure),
    shelf with fences and an adjustable M3 slot puts the LM393 fork
    around the disc with the beam across the slot ring.
    Clash-checked against motor, sensor and wheel proxies: no overlaps.
    Moving each wheel out 25 mm widens the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
    [rover.urdf.xacro]
2026-11-03 Add handle URDF, encoder meshes, extender drawing and browser simulators
    Work that was on the local wheel-extender checkout but never committed:
    the haptic handle in the URDF (handle.urdf.xacro, generated by
    tools/handle_to_urdf.py), shaft extender / encoder / handle meshes, the
    extender drawing script and the two browser simulators.
    Also locks the handle hinge in bringup: nothing publishes its joint state,
    so a revolute handle never reached TF. description.launch.py gains a
    handle_joint argument (default revolute); bringup passes fixed.
    [encoder_disc.stl, encoder_holder_left.stl, encoder_holder_right.stl, encoder_sensor_left.stl, encoder_sensor_right.stl, handle.urdf.xacro, handle_frame.stl, handle_grip.stl]
2026-11-03 Reorganise by computer, add one-command Pi setup, fix pin map
    Layout - each top-level folder is one part of the robot:
    esp32/ rover_microros (the firmware), rover_control, tests/
    raspberry_pi/ setup_pi.sh, run_rover.sh, scripts/, ros/
    haptic_handle/ was _cane_later
    cad/ encoder extender and disc
    simulation/ was sim
    docs/ BUILD, INTEGRATION, MICROROS, WIRING, WIRELESS, CANE
    Moves are git mv, so history follows. Every path in the docs, code
    comments, bringup's agent_script default, encoder_extender.py's output
    paths and .gitignore's mesh exception is updated to match.
    Pi:
    - raspberry_pi/setup_pi.sh: one-time setup on Ubuntu 24.04 - ROS 2 Jazzy,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
    [assistive_home.sdf, assistive_world.sdf, camera.stl, chassis.stl, drl_eval_20261010_214608_INVALID_bt_server_timeout.csv, drl_eval_run2_20261010_214914_passA_trapped_at_doorpost.csv, drl_run2_nopillar_A_20261010_223736_INVALID_controller_crashed.csv, drl_run2_nopillar_A_20261010_224422.csv]
2026-11-03 Add local work that never reached GitHub: 3D simulator source, vibrator test, grip sim plots
    Found by comparing every file in the local working copy against main:
    31 files had never been committed.
    - simulation/v2/: source parts of guide_dog_simulator_3d.html (build.sh
    joins them; tools/ regenerates the meshes and embeds the fonts; vendor/
    holds three.js r128, MIT, and two OFL fonts so the page runs offline).
    export_urdf_meshes.py now reads the meshes from raspberry_pi/ros/.
    - esp32/tests/vibrator_test/: bench test for the four handle vibration
    modules. Added as written; its LEFT/RIGHT pins (5/15) differ from
    rover_microros/pins.h (21/22) - to be settled against the real wiring.
    -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
    [pins.h, vibrator_test.ino]
2026-11-03 vibrator_test: use GPIO 21/22 for left/right, same as the firmware
    The modules are wired to 21/22 (PIN_HAP_LEFT/RIGHT in rover_microros/pins.h).
    The sketch had 5/15 to avoid I2C, but the MPU6050 is on the Pi, so 21/22 are
    free. Also bring the firmware's free-pin list in line with WIRING.md.
    [pins.h, vibrator_test.ino]
2026-11-06 Shaft extender + encoder disc: three fit-iteration sizes (A/B/C)
    The last print was too tight on the motor shaft, the wheel pin was too fat
    and too short, and the disc hole was too tight on the extender body.
    - motor-shaft bore 5.9 -> 6.2 / 6.5 / 6.8
    - wheel pin 6.3 x 15 -> 6.0 x 18 / 5.8 x 20 / 5.6 x 22
    - encoder disc hole 17.0 -> 17.3 / 17.6 / 17.9
    The wheel pin length is now its own setting (OUT_LEN), separate from
    HUB_DEPTH, so the hub still seats at X = 30 and the track width stays 290.
    Print-ready STLs are committed in cad/stl/ with a size table.
    Claude-Session: https://claude.ai/code/session_017aLyg38QZjXySy9YfofpZ8
    [Encoder Disc A.stl, Encoder Disc B.stl, Encoder Disc C.stl, Encoder Holder Left.stl, Encoder Holder Right.stl, Shaft Extender A.stl, Shaft Extender B.stl, Shaft Extender C.stl]
